Elecrow-RD/Elecrow-nRFLR1262-Wireless-Transceiver-Module/Dimension_figure/nrflr1262_module4.jpg

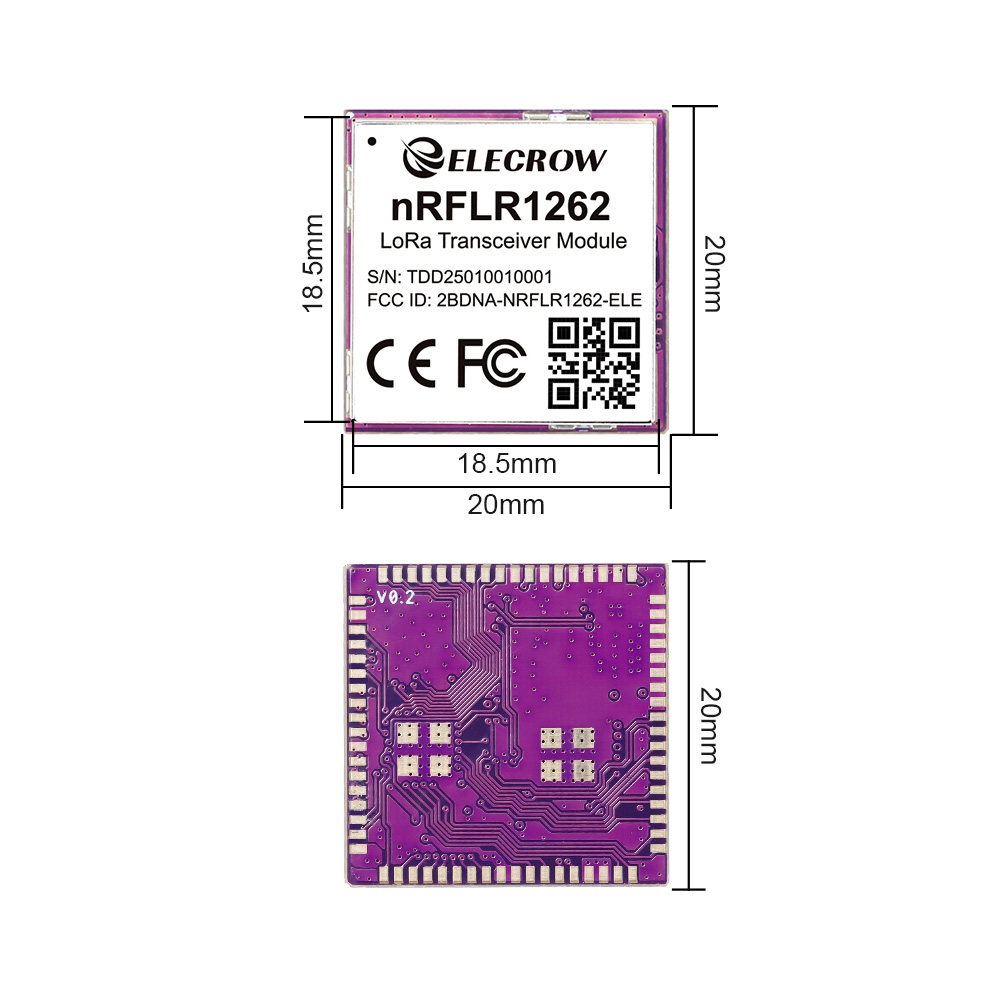
Dimension_figure/nrflr1262_module4.jpg
